adr176/Control-de-acceso-con-Arduino/README.md

# Control-de-acceso-con-Arduino
Trabajo de Fin de Grado de Adrián Navazo y Julia Miguélez

Este proyecto consiste en el diseño e implementación de un dispositivo de control
de acceso para un comedor escolar. Se compone de dos Arduinos, un lector de huellas,
una pantalla TFT LCD y una base de datos dónde se almacena la información. El objetivo del proyecto es facilitar el registro del alumnado y proporcionar datos relevantes
del mismo al personal encargado de la supervisión de ese espacio. Se busca sustituir
otros sistemas más arcaicos como el uso de ficheros físicos o el uso de códigos para
cada alumno. Se presta una atención especial a las alergias alimentarias ya que este sistema puede ayudar a prevenir errores con consecuencias no deseadas.
